semtronik/link-hardware/board/link-base-brd/outputs/link-base-brd-v0.2.0-bom.csv

Reference | Quantity | Description | Manufacturer | Manufacturer PN | DNP | Notes
C1,C2,C4,C9,C12,C21,C23 | 7 | Capacitor, 10uF, 25V, X5R, 0805 | Samsung | CL21A106KAYNNNE
C3 | 1 | Capacitor, 10uF, 10V, X5R, 0603 | TDK | C1608X5R1A106K080AC
C5 | 1 | Capacitor, 0.01uF, 50V, X7R, 0603 | Yageo | CC0603KRX7R9BB103
C6,C8,C13,C22,C24,C25 | 6 | Capacitor, 0.1uF, 50V, X7R, 0603 | Yageo | CC0603KRX7R9BB104
C7 | 1 | Capacitor, 120pF, 50V, C0G, 0603 | Samsung | CL10C121JB81PNC
C10,C11 | 2 | Capacitor, 22uF, 10V, X5R, 0805 | Samsung | CL21A226MPQNNNE
C14,C17 | 2 | Capacitor, 1uF, 50V, X5R, 0603 | Samsung | CL10A105KB8NNNC
C15,C16,C18 | 3 | Capacitor, 15pF, 50V, C0G, 0603 | Samsung | CL10C150JB8NNNC | DNP
D1,D2,D3,D4 | 4 | Diode standard, 75V 250MA, SOD123 | SMC Diode Solutions | 1N4148W
D6 | 1 | Diode, TVS, SOT-143 | Nexperia | PRTR5V0U2X,215
F1,F2 | 2 | PTC, 0.75A hold, 6V, 1206 | Bourns | MF-NSMF075-2
J1 | 1 | Connector, Header, 1x3, 2.5mm, TH | JST | B3B-XH-AM
J2 | 1 | Generic connector, double row, 02x03, odd/even pin numbering scheme (row 1 odd numbers, row 2 even numbers), script generated (kicad-library-utils/schlib/autogen/connector/) |  |  | DNP
J3 | 1 | Connector, Socket, 2x10, 2mm, Vertical, Height=4.6mm, SMD | Wurth | 621320242921 |  | HCTL - PM200-2-10-S-4.3
J5 | 1 | Connector, USB-C Receptacle 16P, USB 2.0, SMD | GCT | USB4105-GF-A
J6 | 1 | Connector, FPC, 6pos, 1mm, SMD | Molex | 52271-0679
J7 | 1 | Connector, FPC, 40pos, 0.5mm, SMD | Molex | 54132-4062
L1 | 1 | Inductor, 470nH, 4.5A, 26mOhm, 0806 | Murata | DFE201612E-R47M=P2
Q1,Q3 | 2 | Transistor, Mosfet, P-Channel, 4A, 30V, SOT-23 | Alpha & Omega Semiconductor Inc. | AO3401A
Q2 | 1 | Transistor, Mosfet, N-Channel, 5.7A, 30V, SOT-23 | Alpha & Omega Semiconductor Inc. | AO3400A
R1,R15,R16,R17,R18,R19,R20,R23,R24,R25 | 10 | Resistor,10k, 1%, 0.1W, 0603 | Yageo | RC0603FR-0710KL
R2 | 1 | Resistor,3.k, 1%, 0.1W, 0603 | Yageo | RC0603FR-073KL
R3,R4,R5,R6,R7,R11,R14,R32,R33,R34 | 10 | Resistor,100k, 1%, 0.1W, 0603 | Yageo | RC0603FR-07100KL
R8 | 1 | Resistor,1.5k, 1%, 0.1W, 0603 | Yageo | RC0603FR-071K5L
R9 | 1 | Resistor,1.8k, 1%, 0.1W, 0603 | Yageo | RC0603FR-071K8L
R10 | 1 | Resistor, 1M, 1%, 0.1W, 0603 | Yageo | RC0603FR-071ML
R12 | 1 | Resistor,453k, 1%, 0.1W, 0603 | Yageo | RC0603FR-07453KL
R13 | 1 | Resistor,150k, 1%, 0.1W, 0603 | Yageo | RC0603FR-07150KL
R21,R22 | 2 | Resistor, 22R, 1%, 0.1W, 0603 | Yageo | RC0603FR-0722RL
R30,R31 | 2 | Resistor,5.1k, 1%, 0.1W, 0603 | Yageo | RC0603FR-075K1L
R35 | 1 | Resistor,3.3k, 1%, 0.1W, 0603 | Yageo | RC0603FR-073K3L
SW1 | 1 | Tactile switch, SPST-NO, 0.05A 12V, SMD | Panasonic | EVQ-PUA02K
U1 | 1 | IC, Li-Ion Battery Charger and Power-Path Management, VQFN-16 | Texas Instruments | BQ24074RGTR
U2 | 1 | IC, BATT MON, LI-ION 1CELL, 8TDFN | Analog Devices | MAX17048G+
U3 | 1 | IC, Regulator, Buck, ADJ, 1A, QFN-8 | Texas Instruments | TPS62821DLCR
U4 | 1 | IC, MCU, ESP32-S3-WROOM, 16MB Flash, 8MB PSRAM, Int. Ant. | Espressif | ESP32-S3-WROOM-1-N16R8
U5 | 1 | Realtime Clock/Calendar I2C Interface, SOIC-8 | NXP | PCF8563T/5,518
U6 | 1 | IC, Led Driver Linear, 175mA, 8SOIC | onsemi | CAT4104V-GT3
Y1 | 1 | Crystal, 32.768Khz, 9pF, SMD | Micro Crystal AG | CM8V-T1A-32.768KHZ-9PF-20PPM-TA-QC
