semtronik/link-hardware/board/link-base-brd/outputs/link-base-brd-v0.2.0.step

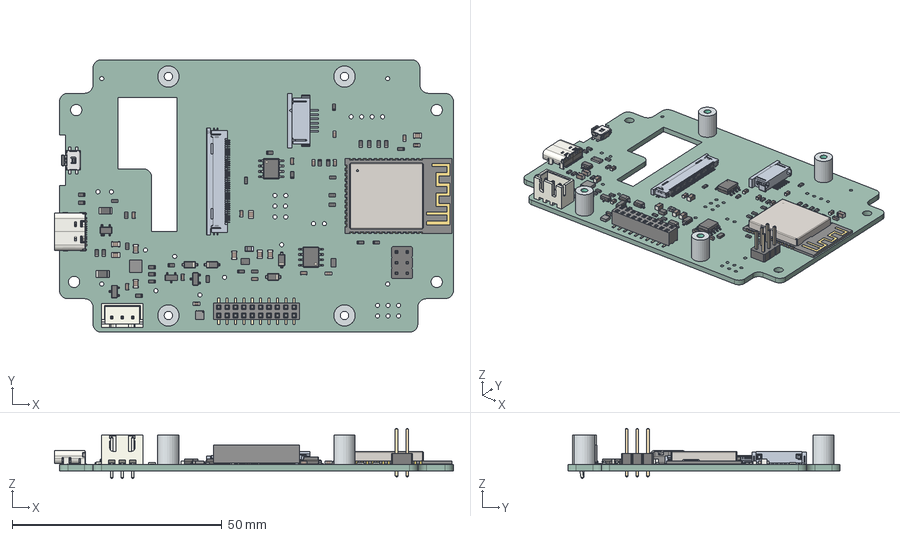
[picture p1: CAD file, 2026-08-31]
board/link-base-brd/outputs/link-base-brd-v0.2.0.step
95.2 x 65.0 x 11.9 mm
PinHeader_2x03_P254mm_Vertical
BODY-QFN
PIN1-ID
SOIC_8_39x49mm_P127mm x 2
R_0603_1608Metric x 31
USB_C_Receptacle_16P_TopMnt_Horizontal_GCT_USB4105-xx-A
C_0805_2012Metric x 9
C_0603_1608Metric x 14
SOT_143
MicroCrystal_CC8V_T1A
D_SOD_123 x 4
Body^BF100-xxxx_20
Pin^BF100-xxxx x 10
Fuse_1206_3216Metric x 2
C0201_20210301.STEP^C0201_20210301.STEP_Submodel-C0201_part_ DesignRootModel_PCB_ESP32-S3-WROOM-1_V1(2)_PCB_ESP32-S3-WROOM-1_V1 x 14
L0201_20210301.STEP^L0201_20210301.STEP_Submodel-L0201_part_ DesignRootModel_PCB_ESP32-S3-WROOM-1_V1(2)_PCB_ESP32-S3-WROOM-1_V1 x 3
C0402_20210301.STEP^C0402_20210301.STEP_Submodel-C0402_part_ DesignRootModel_PCB_ESP32-S3-WROOM-1_V1(2)_PCB_ESP32-S3-WROOM-1_V1
R0201_20210301.STEP^R0201_20210301.STEP_Submodel-R0201_part_ DesignRootModel_PCB_ESP32-S3-WROOM-1_V1(2)_PCB_ESP32-S3-WROOM-1_V1 x 8
trace_1^Submodel-MINI-ANT-TYPEB_668419613_part_DesignRootModel_PCB_ ESP32-S3-WROOM-1_V1(2)_PCB_ESP32-S3-WROOM-1_V1
DFN1006.STEP^DFN1006.STEP_Submodel-SOD882_part_DesignRootModel_PCB_ ESP32-S3-WROOM-1_V1(2)_PCB_ESP32-S3-WROOM-1_V1
SOP8_rev1_20210308.STEP^SOP8_rev1_20210308.STEP_Submodel-SOP8_1P27_6P6_ part_DesignRootModel_PCB_ESP32-S3-WROOM-1_V1(2)_PCB_ESP32-S3-WROOM-1_V1
XTAL3225_20210301.STEP^XTAL3225_20210301.STEP_Submodel-XTAL3225_part_ DesignRootModel_PCB_ESP32-S3-WROOM-1_V1(2)_PCB_ESP32-S3-WROOM-1_V1
ESP32-S3_20210301.STEP^ESP32-S3_20210301.STEP_Submodel-QFN56_0P4_7_ part_DesignRootModel_PCB_ESP32-S3-WROOM-1_V1(2)_PCB_ESP32-S3-WROOM-1_V1
uid__4-128^DesignRootModel_PCB_ESP32-S3-WROOM-1_V1(2)_PCB_ ESP32-S3-WROOM-1_V1
uid__4-129^DesignRootModel_PCB_ESP32-S3-WROOM-1_V1(2)_PCB_ ESP32-S3-WROOM-1_V1
uid__4-130^DesignRootModel_PCB_ESP32-S3-WROOM-1_V1(2)_PCB_ ESP32-S3-WROOM-1_V1
uid__4-149^DesignRootModel_PCB_ESP32-S3-WROOM-1_V1(2)_PCB_ ESP32-S3-WROOM-1_V1
uid__4-150^DesignRootModel_PCB_ESP32-S3-WROOM-1_V1(2)_PCB_ ESP32-S3-WROOM-1_V1
uid__4-151^DesignRootModel_PCB_ESP32-S3-WROOM-1_V1(2)_PCB_ ESP32-S3-WROOM-1_V1
uid__4-167^DesignRootModel_PCB_ESP32-S3-WROOM-1_V1(2)_PCB_ ESP32-S3-WROOM-1_V1
uid__4-168^DesignRootModel_PCB_ESP32-S3-WROOM-1_V1(2)_PCB_ ESP32-S3-WROOM-1_V1
uid__4-169^DesignRootModel_PCB_ESP32-S3-WROOM-1_V1(2)_PCB_ ESP32-S3-WROOM-1_V1
uid__1-279^DesignRootModel_PCB_ESP32-S3-WROOM-1_V1(2)_PCB_ ESP32-S3-WROOM-1_V1
uid__1-280^DesignRootModel_PCB_ESP32-S3-WROOM-1_V1(2)_PCB_ ESP32-S3-WROOM-1_V1
uid__1-292^DesignRootModel_PCB_ESP32-S3-WROOM-1_V1(2)_PCB_ ESP32-S3-WROOM-1_V1
uid__1-298^DesignRootModel_PCB_ESP32-S3-WROOM-1_V1(2)_PCB_ ESP32-S3-WROOM-1_V1
uid__1-299^DesignRootModel_PCB_ESP32-S3-WROOM-1_V1(2)_PCB_ ESP32-S3-WROOM-1_V1
uid__1-300^DesignRootModel_PCB_ESP32-S3-WROOM-1_V1(2)_PCB_ ESP32-S3-WROOM-1_V1
uid__1-301^DesignRootModel_PCB_ESP32-S3-WROOM-1_V1(2)_PCB_ ESP32-S3-WROOM-1_V1
uid__1-304^DesignRootModel_PCB_ESP32-S3-WROOM-1_V1(2)_PCB_ ESP32-S3-WROOM-1_V1
uid__1-305^DesignRootModel_PCB_ESP32-S3-WROOM-1_V1(2)_PCB_ ESP32-S3-WROOM-1_V1
uid__1-308^DesignRootModel_PCB_ESP32-S3-WROOM-1_V1(2)_PCB_ ESP32-S3-WROOM-1_V1
uid__1-310^DesignRootModel_PCB_ESP32-S3-WROOM-1_V1(2)_PCB_ ESP32-S3-WROOM-1_V1
uid__1-311^DesignRootModel_PCB_ESP32-S3-WROOM-1_V1(2)_PCB_ ESP32-S3-WROOM-1_V1
uid__1-325^DesignRootModel_PCB_ESP32-S3-WROOM-1_V1(2)_PCB_ ESP32-S3-WROOM-1_V1
uid__1-334^DesignRootModel_PCB_ESP32-S3-WROOM-1_V1(2)_PCB_ ESP32-S3-WROOM-1_V1
uid__1-338^DesignRootModel_PCB_ESP32-S3-WROOM-1_V1(2)_PCB_ ESP32-S3-WROOM-1_V1
uid__1-339^DesignRootModel_PCB_ESP32-S3-WROOM-1_V1(2)_PCB_ ESP32-S3-WROOM-1_V1
uid__1-340^DesignRootModel_PCB_ESP32-S3-WROOM-1_V1(2)_PCB_ ESP32-S3-WROOM-1_V1
uid__1-343^DesignRootModel_PCB_ESP32-S3-WROOM-1_V1(2)_PCB_ ESP32-S3-WROOM-1_V1
uid__1-344^DesignRootModel_PCB_ESP32-S3-WROOM-1_V1(2)_PCB_ ESP32-S3-WROOM-1_V1
uid__1-345^DesignRootModel_PCB_ESP32-S3-WROOM-1_V1(2)_PCB_ ESP32-S3-WROOM-1_V1
uid__1-352^DesignRootModel_PCB_ESP32-S3-WROOM-1_V1(2)_PCB_ ESP32-S3-WROOM-1_V1
uid__1-354^DesignRootModel_PCB_ESP32-S3-WROOM-1_V1(2)_PCB_ ESP32-S3-WROOM-1_V1
uid__1-355^DesignRootModel_PCB_ESP32-S3-WROOM-1_V1(2)_PCB_ ESP32-S3-WROOM-1_V1
uid__1-357^DesignRootModel_PCB_ESP32-S3-WROOM-1_V1(2)_PCB_ ESP32-S3-WROOM-1_V1
uid__1-358^DesignRootModel_PCB_ESP32-S3-WROOM-1_V1(2)_PCB_ ESP32-S3-WROOM-1_V1
uid__1-359^DesignRootModel_PCB_ESP32-S3-WROOM-1_V1(2)_PCB_ ESP32-S3-WROOM-1_V1
uid__1-364^DesignRootModel_PCB_ESP32-S3-WROOM-1_V1(2)_PCB_ ESP32-S3-WROOM-1_V1
uid__1-365^DesignRootModel_PCB_ESP32-S3-WROOM-1_V1(2)_PCB_ ESP32-S3-WROOM-1_V1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
