semtronik/link-hardware/board/link-mod-lr-brd/outputs/link-mod-lr-brd-v0.2.0.step

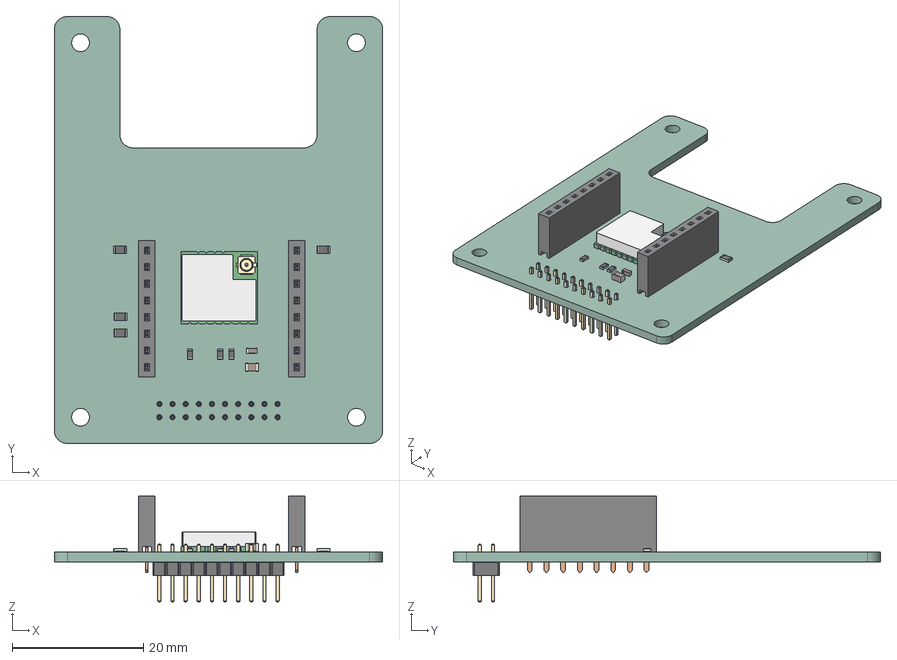
[picture p2: CAD file, 2026-08-31]
board/link-mod-lr-brd/outputs/link-mod-lr-brd-v0.2.0.step
50.0 x 65.0 x 16.1 mm
C_0603_1608Metric
6130xx11821_PIN x 16
R_0805_2012Metric x 4
PCB
PCB001
PCB002
R_0603_1608Metric x 3
C_0805_2012Metric
PinHeader_2x10_P200mm_Vertical
link-mod-lr-brd_PCB
