semtronik/link-hardware/mechanical/link-case-bot-v0.1.0.step

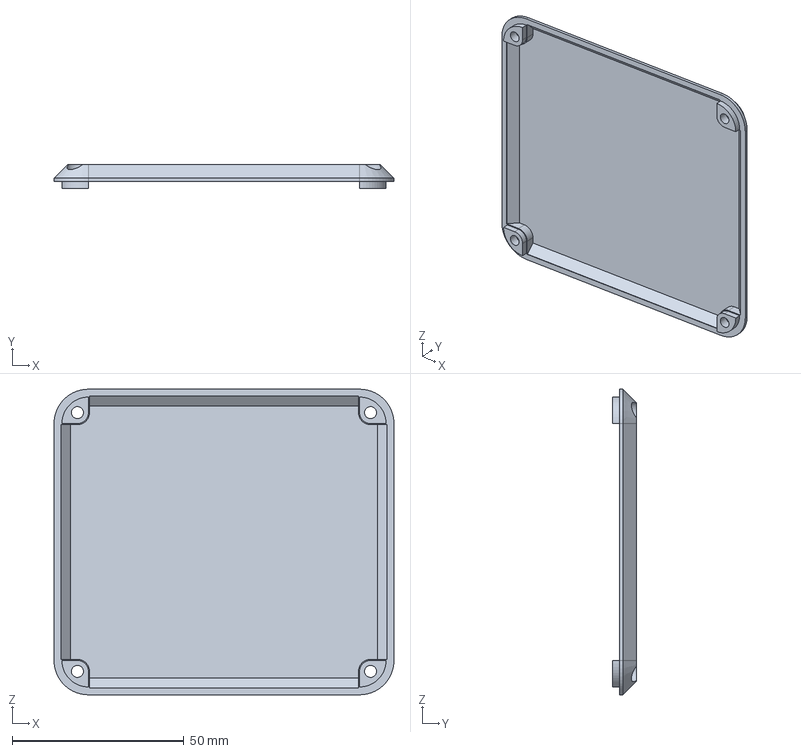
[picture p3: CAD file, 2026-08-31]
mechanical/link-case-bot-v0.1.0.step
99.0 x 7.00 x 89.0 mm
