semtronik/link-hardware/mechanical/link-case-top-v0.1.0.step

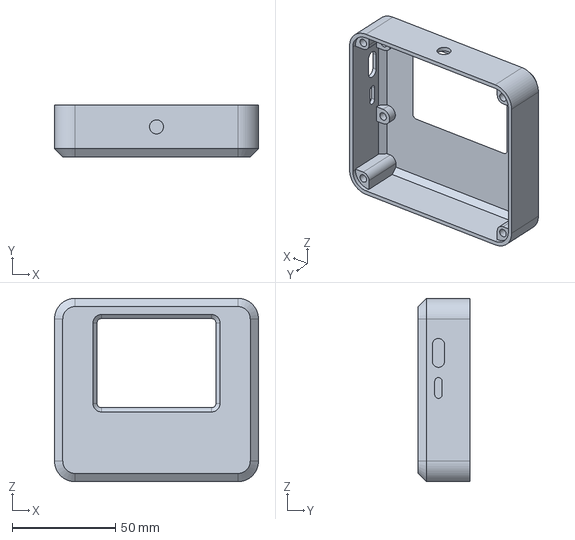
[picture p4: CAD file, 2026-08-31]
mechanical/link-case-top-v0.1.0.step
99.0 x 25.0 x 89.0 mm
