semtronik/link-hardware/board/link-base-brd/outputs/link-base-brd-v0.2.0-schematic.pdf

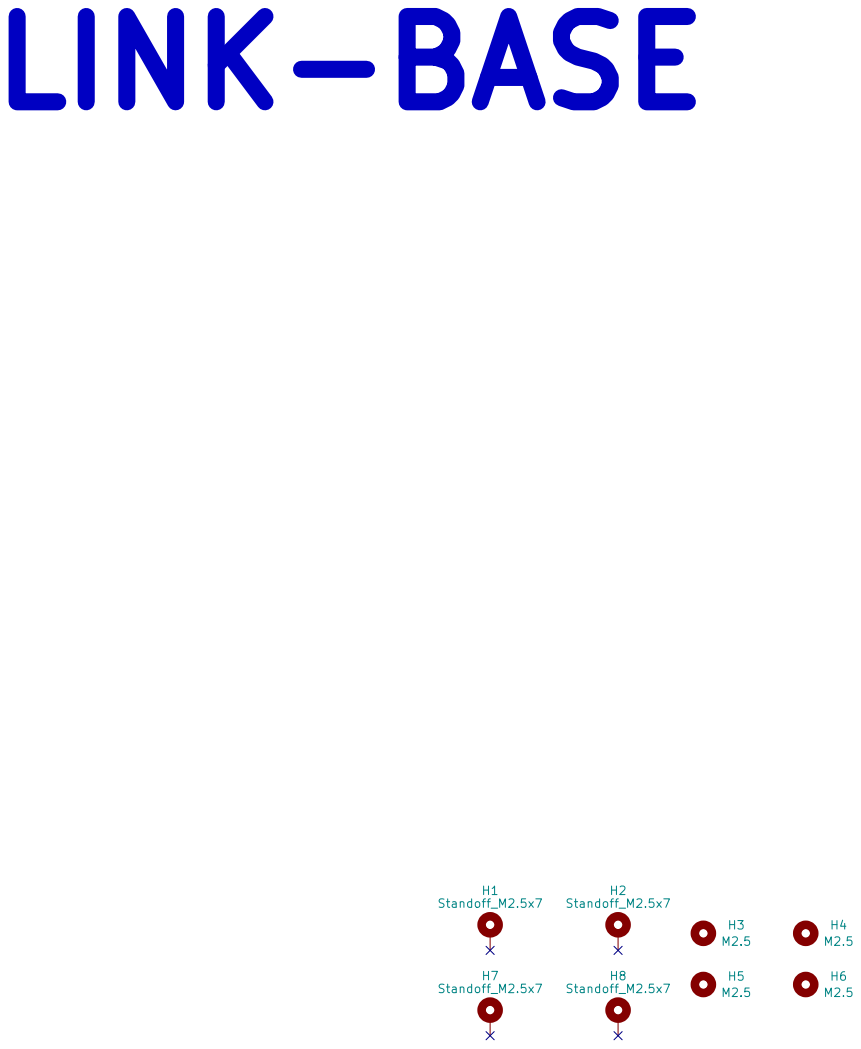
[picture p5: page 1]

Sheet: /link-base-brd/
File: link-base-brd.kicad_sch
Title: Link Base Board

Size: A3 | Rev: 0.2.0 | F Date: 2026-08-28
KiCad E.D.A. 10.0.5 | Id: 1/6

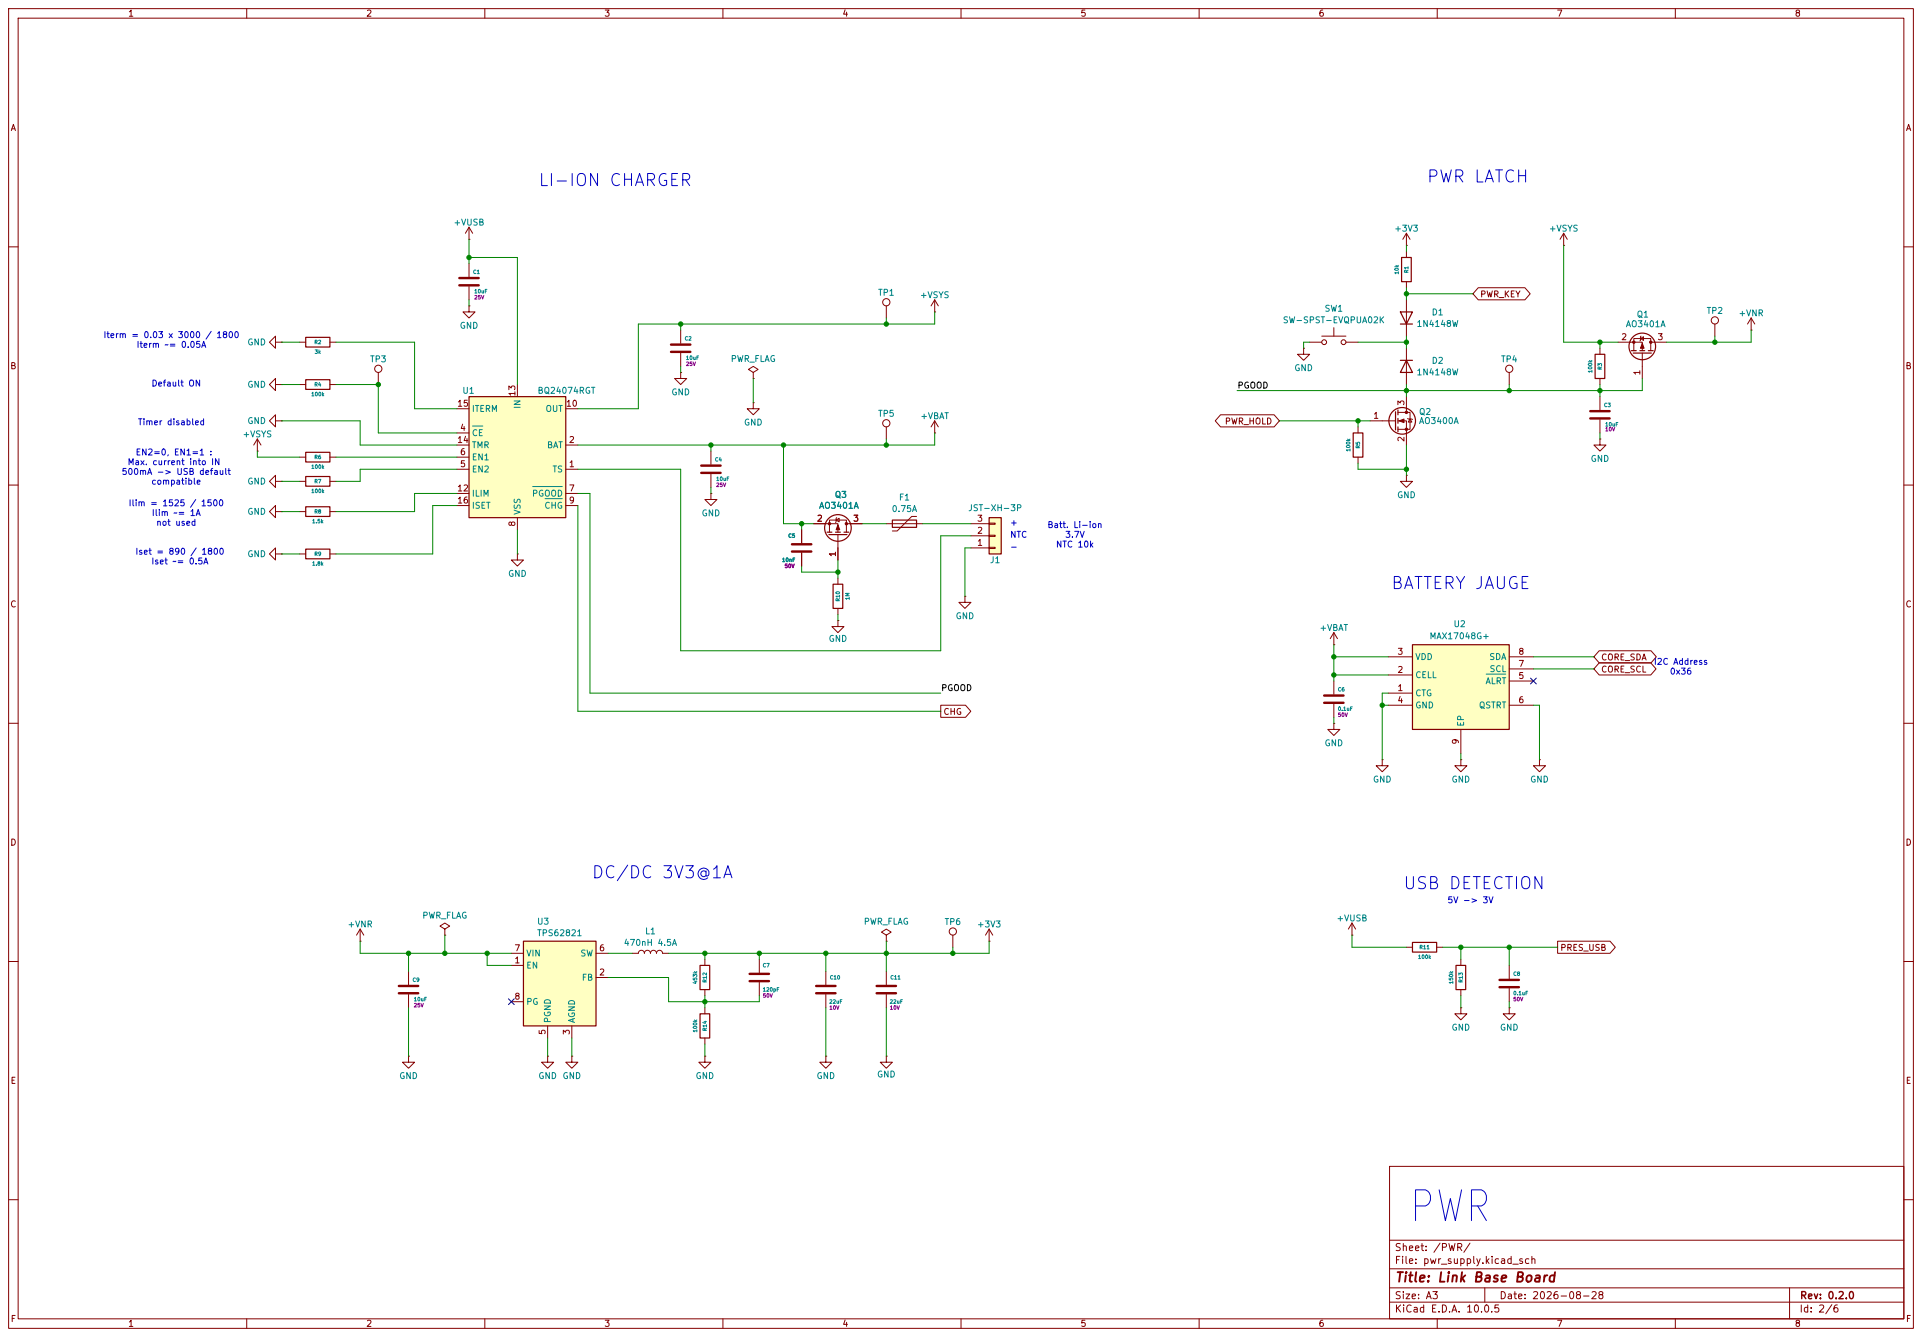
[picture p6: page 2]

Iterm = 0.03 x 3000 / 1800
Iterm ~= 0.05A EN2=0, EN1=1 : Max. current into IN 500mA -> USB default compatible

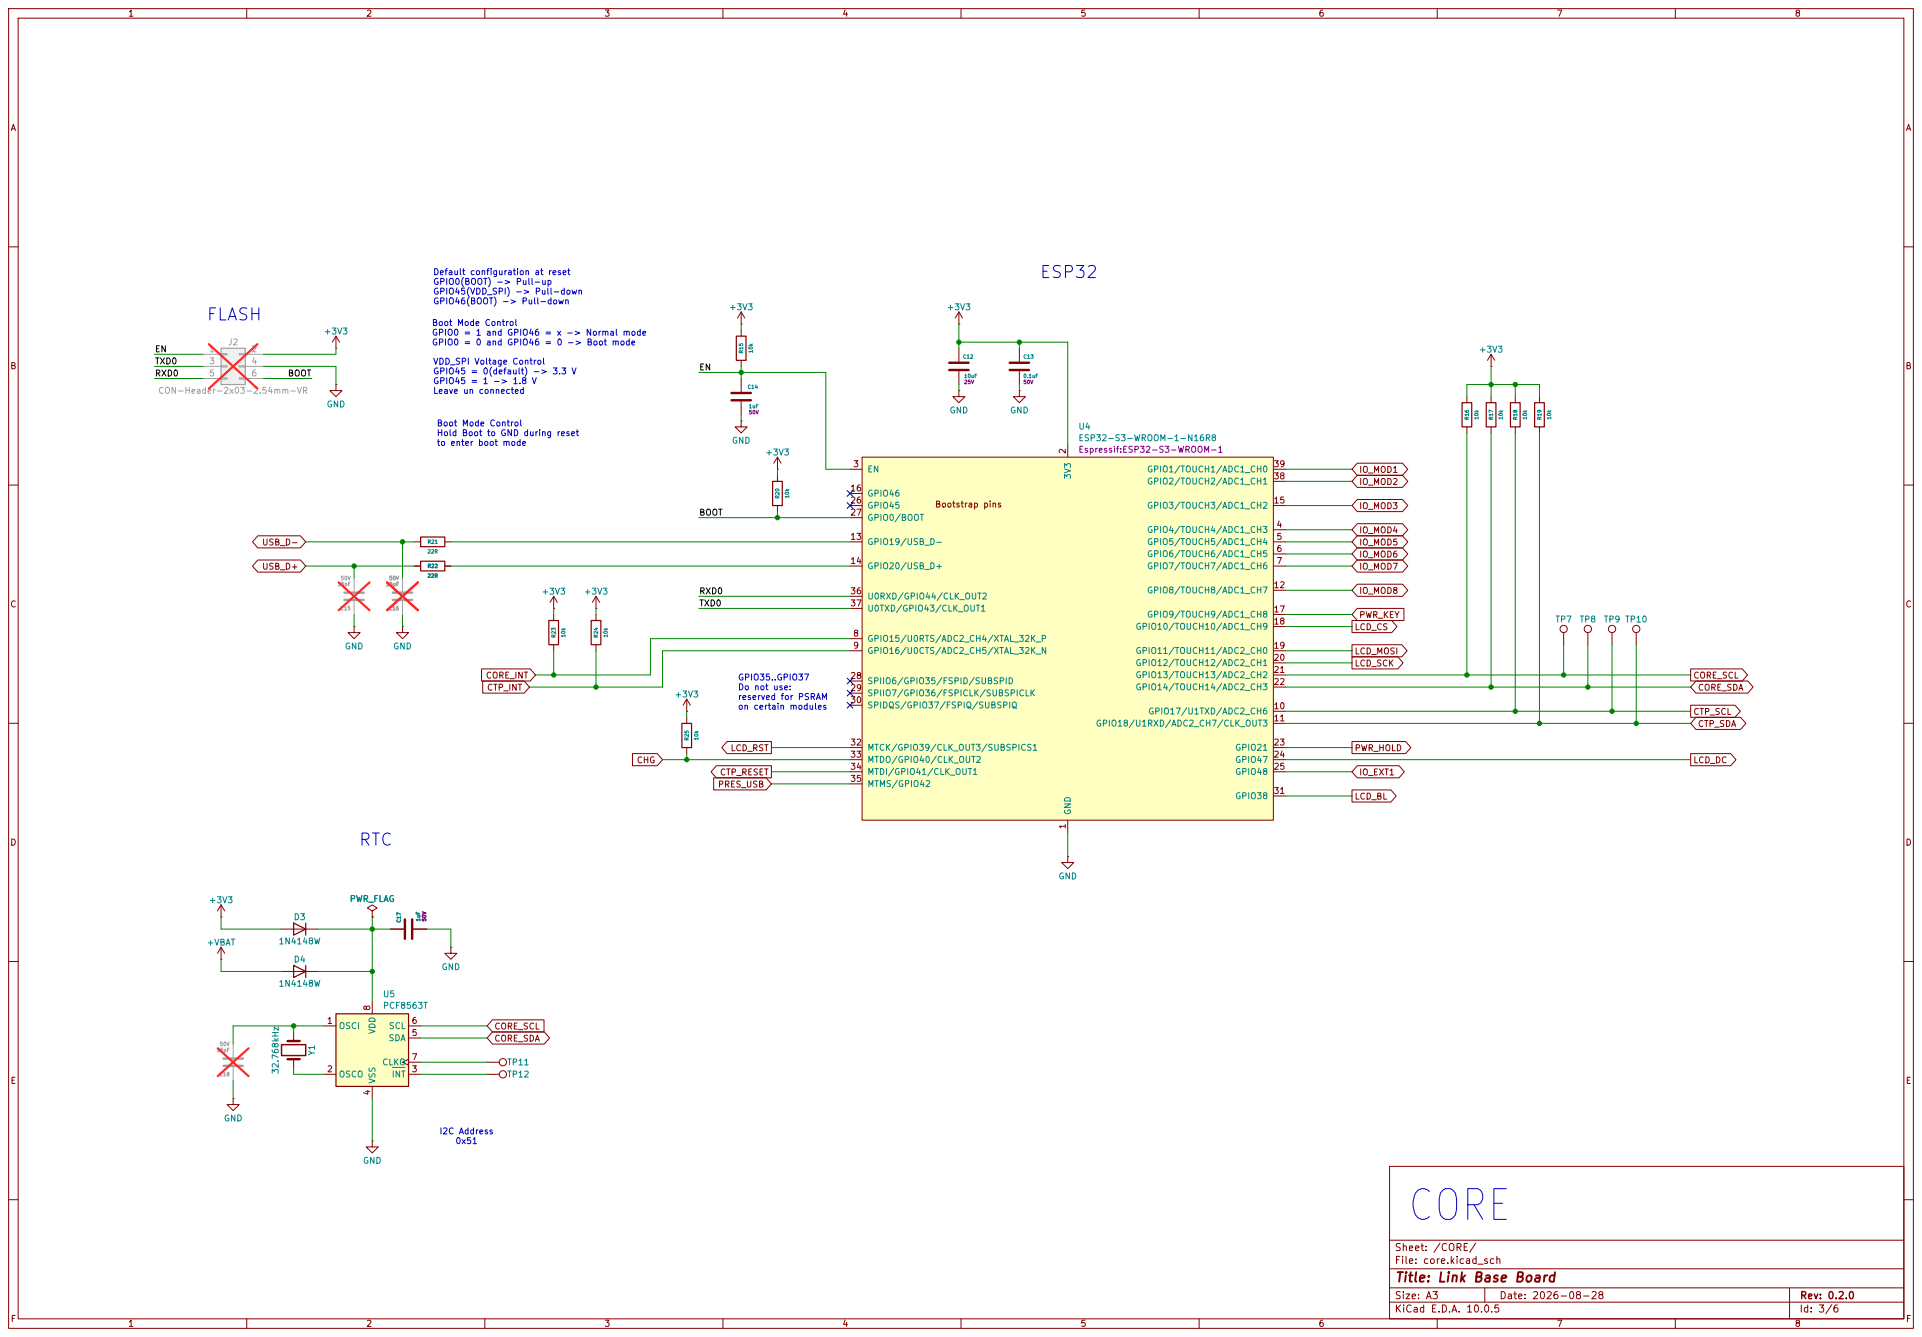
[picture p7: page 3]

Default configuration at reset GPIO0(BOOT) -> Pull-up

Boot Mode Control GPIO0 = 1 and GPIO46 = x -> Normal mode GPIO0 = 0 and GPIO46 = 0 -> Boot mode RTC

Boot Mode Control Hold Boot to GND during reset

reserved for PSRAM on certain modules

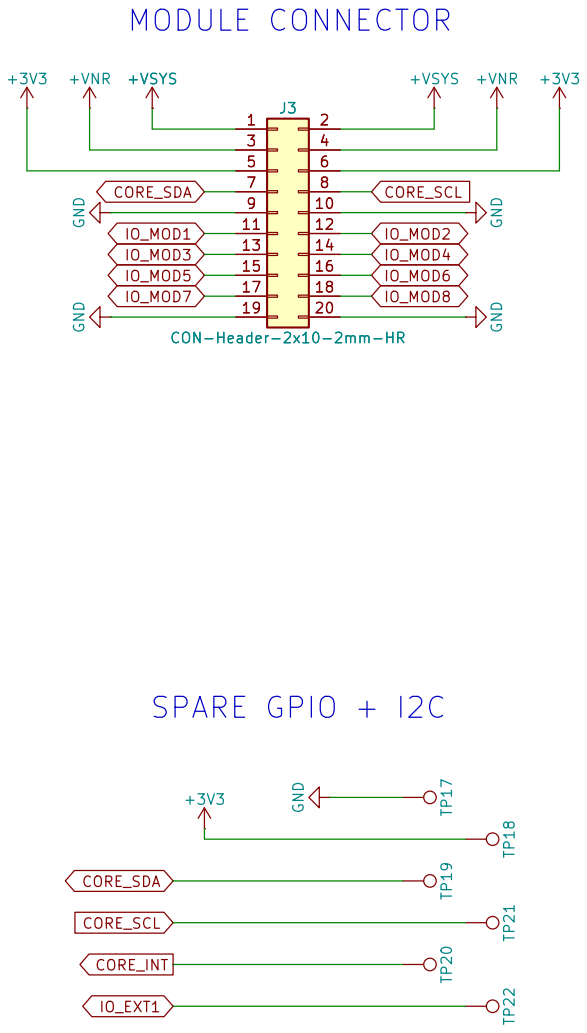
[picture p8: page 4]

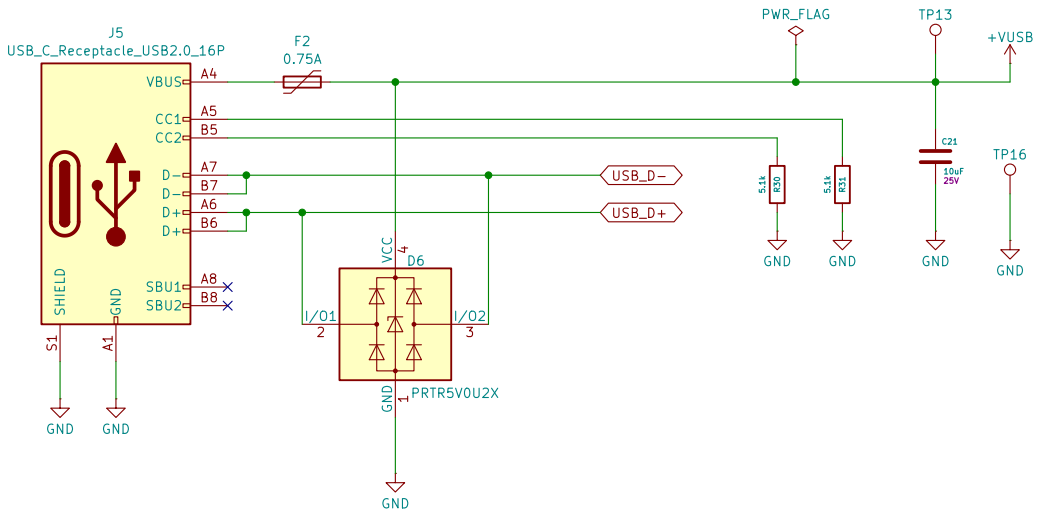
[picture p9: page 5]

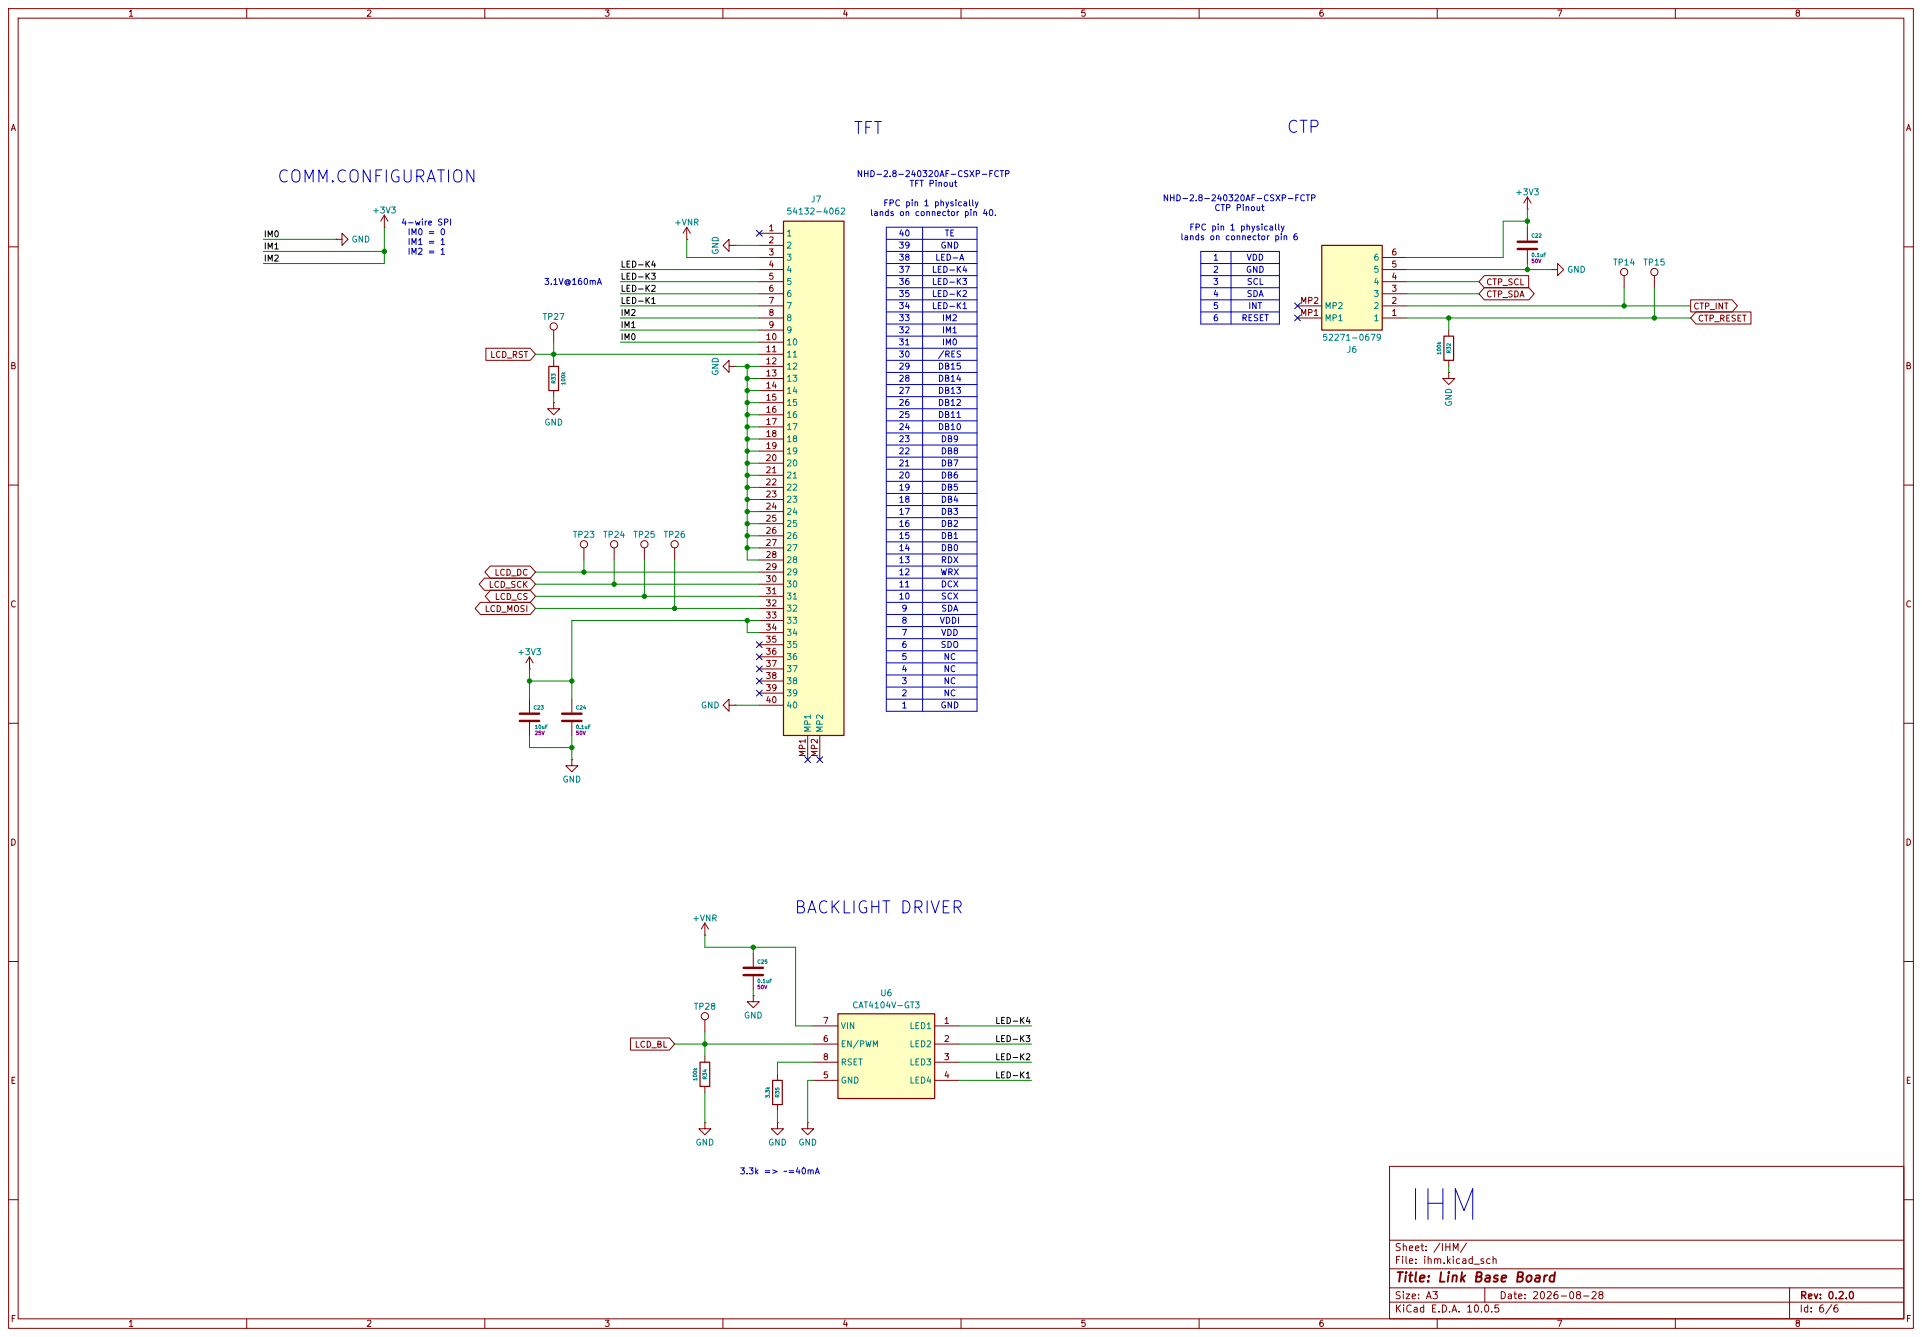
[picture p10: page 6]

TFT Pinout FPC pin 1 physically

NHD-2.8-240320AF-CSXP-FCTP
CTP Pinout FPC pin 1 physically

lands on connector pin 6

2 | GND

36 | LED-K3
35 | LED-K2
34 | LED-K1
33 | IM2
32 | IM1
31 | IM0
30 | /RES
29 | DB15
28 | DB14
27 | DB13
26 | DB12
25 | DB11
24 | DB10
23 | DB9
22 | DB8
21 | DB7
20 | DB6
19 | DB5
18 | DB4
17 | DB3
16 | DB2
15 | DB1
14 | DB0
13 | RDX
12 | WRX
11 | DCX
10 | SCX
9 | VDDI 7 VDD SDA 8

6 | SDO
5 | NC
4 | NC
3 | NC
2 | NC
1 | GND
