semtronik/link-hardware/board/link-mod-lr-brd/outputs/link-mod-lr-brd-v0.2.0-schematic.pdf

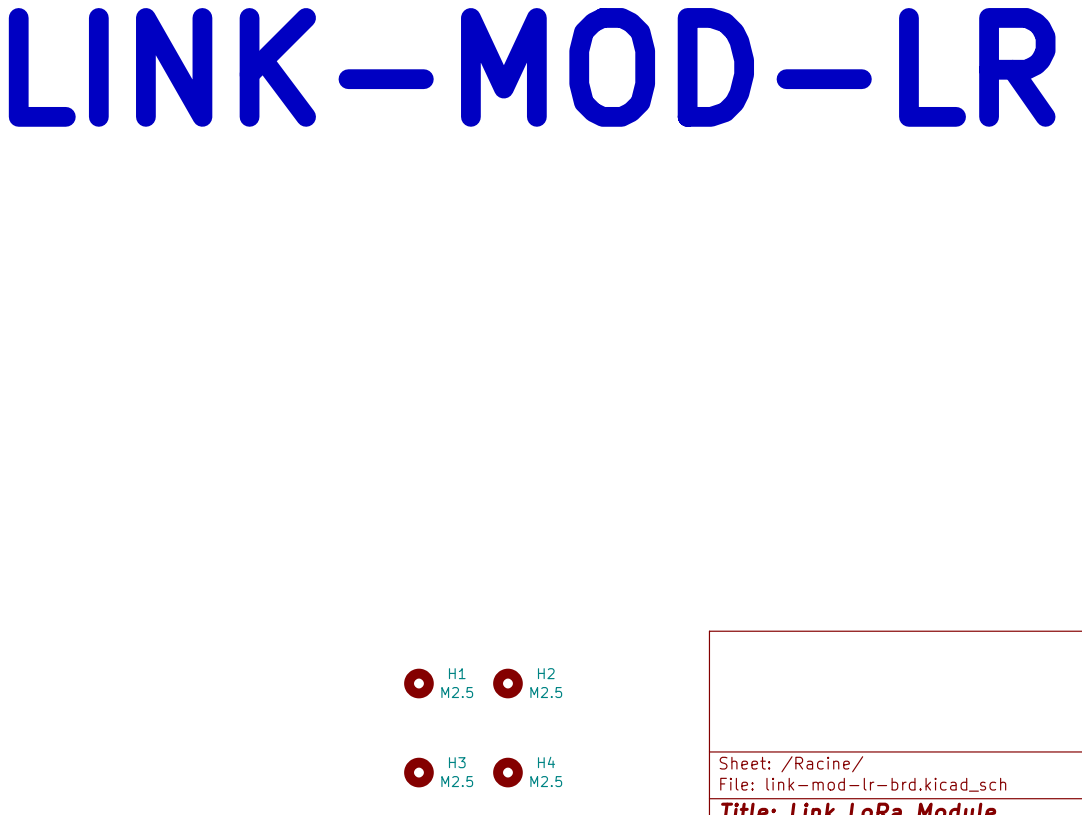
[picture p11: page 1]

Sheet: /Racine/
File: link-mod-lr-brd.kicad_sch
Title: Link LoRa Module

Size: A4 | Rev: 0.2.0
KiCad E.D.A. 10.0.5 | Id: 1/2

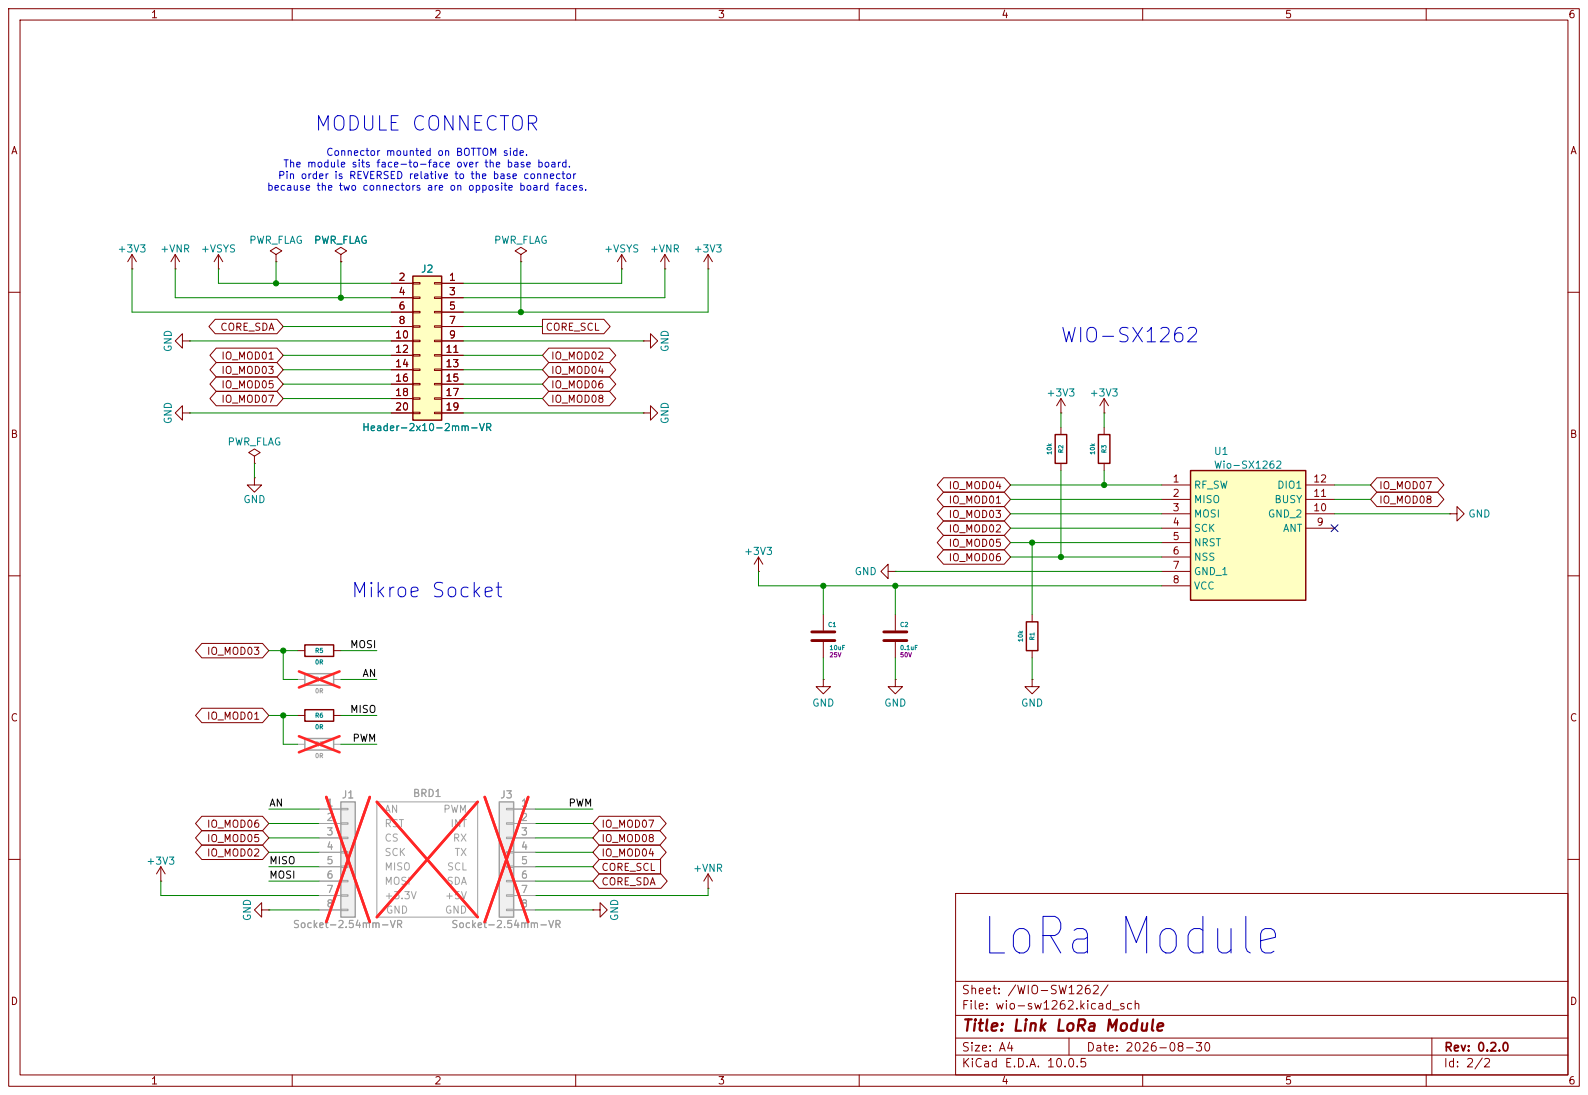
[picture p12: page 2]

BRD1
RST CS
SCK MISO MOSI +3.3V GND
SCL SDA +5V GND

File: wio-sw1262.kicad_sch
Title: Link LoRa Module

Size: A4 | Rev: 0.2.0
KiCad E.D.A. 10.0.5 | Id: 2/2
