semtronik/link-hardware/board/link-mod-lr-brd/link-mod-lr-brd.kicad_pcb

## KiCad design board/link-mod-lr-brd/link-mod-lr-brd.kicad_pcb (2026-08-31)

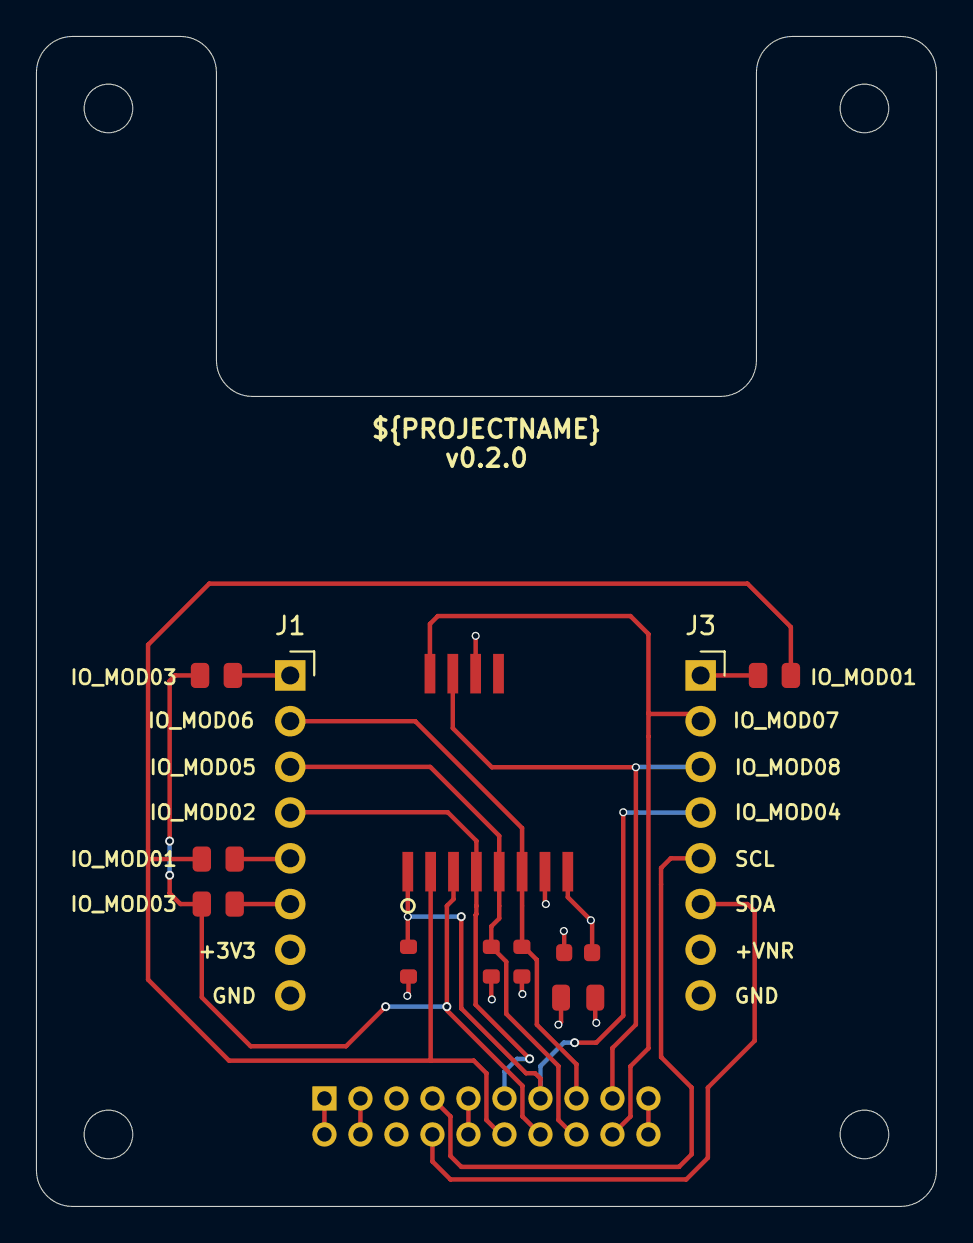
[picture p13: board link-mod-lr-brd.kicad_pcb from above]

Board: 4 copper layers, 50.0 x 65.0 mm, 18 parts (1 on the bottom side), 18 nets.

Parts:
BRD1: BRD-MIKROE-S
C1: 10uF; C_0805_2012Metric
C2: 0.1uF; C_0603_1608Metric
H1, H2, H3, H4: M2.5; MountingHole_2.7mm_M2.5
J1, J3: Socket-2.54mm-VR; PinSocket_1x08_P2.54mm_Vertical
J2: Header-2x10-2mm-VR; PinHeader_2x10_P2.00mm_Vertical
R1, R2, R3: 10k; R_0603_1608Metric
R4, R5, R6, R7: 0R; R_0805_2012Metric
U1: Wio-SX1262; WioSX1262

Connections:
+3V3: C1.1, C2.1, J1.7, J2.5, J2.6, R2.1, R3.1, U1.8 (VCC)
+VNR: J2.3, J2.4, J3.7
+VSYS: J2.1, J2.2
/WIO-SW1262/AN: J1.1, R4.2
/WIO-SW1262/MISO: J1.5, R6.2
/WIO-SW1262/MOSI: J1.6, R5.2
/WIO-SW1262/PWM: J3.1, R7.2
CORE_SCL: J2.7, J3.5
CORE_SDA: J2.8, J3.6
GND: C1.2, C2.2, J1.8, J2.9, J2.10, J2.19, J2.20, J3.8, R1.2, U1.7 (GND_1), U1.10 (GND_2)
IO_MOD01: J2.12, R6.1, R7.1, U1.2 (MISO)
IO_MOD02: J1.4, J2.11, U1.4 (SCK)
IO_MOD03: J2.14, R4.1, R5.1, U1.3 (MOSI)
IO_MOD04: J2.13, J3.4, R3.2, U1.1 (RF_SW)
IO_MOD05: J1.3, J2.16, R1.1, U1.5 (NRST)
IO_MOD06: J1.2, J2.15, R2.2, U1.6 (NSS)
IO_MOD07: J2.18, J3.2, U1.12 (DIO1)
IO_MOD08: J2.17, J3.3, U1.11 (BUSY)
