semtronik/link-hardware/board/link-base-brd/link-base-brd.kicad_pcb

## KiCad design board/link-base-brd/link-base-brd.kicad_pcb (2026-08-31)

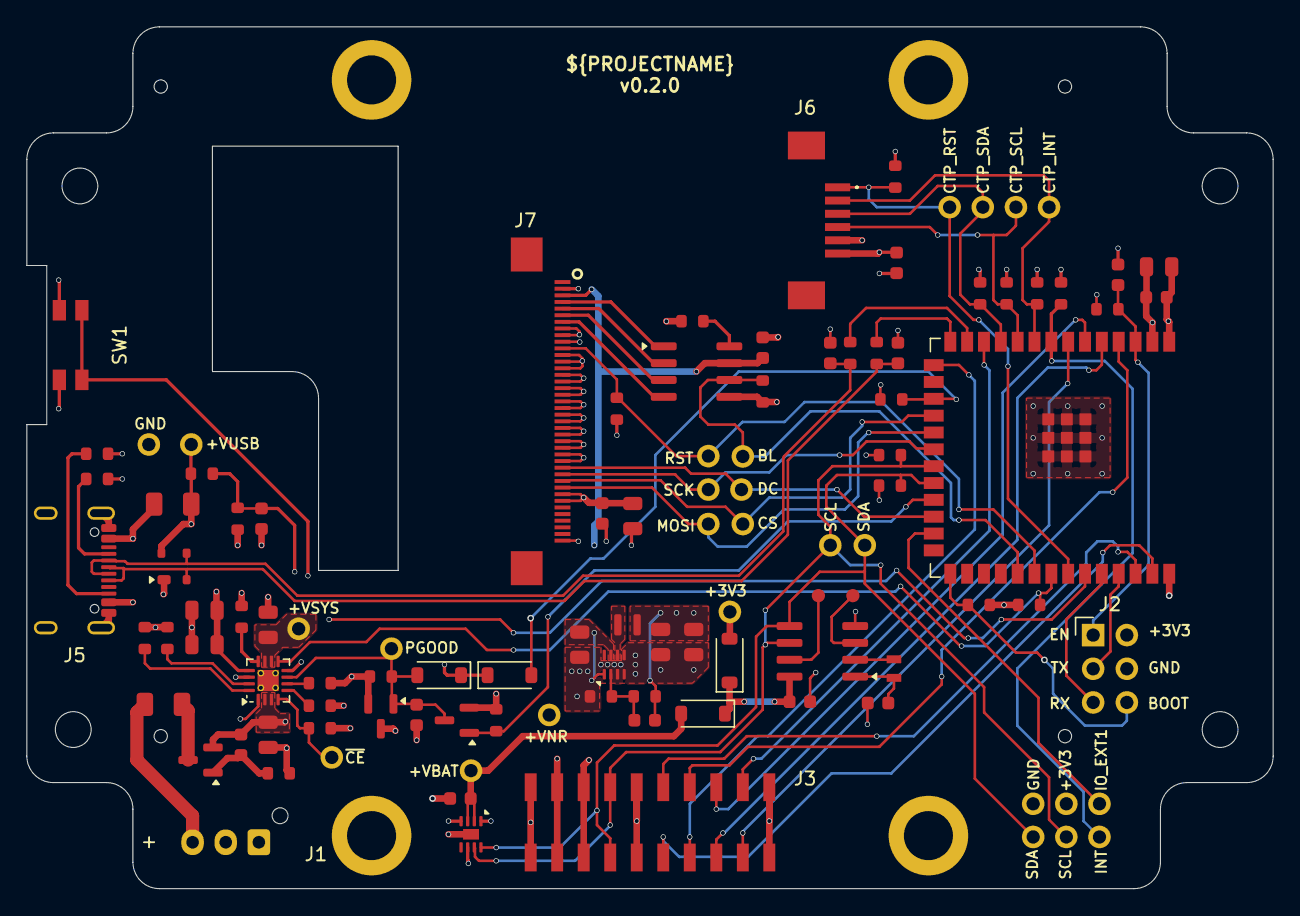
[picture p14: board link-base-brd.kicad_pcb from above]

Board: 4 copper layers, 94.0 x 65.0 mm, 115 parts (0 on the bottom side), 67 nets.

Parts:
C1, C2, C4, C9, C12, C21, C23: 10uF; C_0805_2012Metric
C3: 10uF; C_0603_1608Metric
C5: 10nF; C_0603_1608Metric
C6, C8, C13, C22, C24, C25: 0.1uF; C_0603_1608Metric
C7: 120pF; C_0603_1608Metric
C10, C11: 22uF; C_0805_2012Metric
C14, C17: 1uF; C_0603_1608Metric
C15, C16, C18: 15pF; C_0603_1608Metric
D1, D2, D3, D4: 1N4148W; D_SOD-123
D6: PRTR5V0U2X; SOT-143
F1, F2: 0.75A; Fuse_1206_3216Metric
H1, H2, H7, H8: Standoff_M2.5x7; WA-SMSI_9774070151
H3, H4, H5, H6: M2.5; MountingHole_2.7mm_M2.5
J1: JST-XH-3P; JST_XH_B3B-XH-AM_1x03_P2.50mm_Vertical
J2: CON-Header-2x03-2.54mm-VR; PinHeader_2x03_P2.54mm_Vertical
J3: CON-Header-2x10-2mm-HR; PinSocket_2x10_P2.00mm_Vertical_SMD
J5: USB_C_Receptacle_USB2.0_16P; USB_C_Receptacle_GCT_USB4105-xx-A_16P_TopMnt_Horizontal
J6: 52271-0679; 522710679
J7: 54132-4062; 54132-4062_1
L1: 470nH 4.5A; L_Murata_DFE201610P
Q1, Q3: AO3401A; SOT-23
Q2: AO3400A; SOT-23
R1, R15, R16, R17, R18, R19, R20, R23, R24, R25: 10k; R_0603_1608Metric
R2: 3k; R_0603_1608Metric
R3, R4, R5, R6, R7, R11, R14, R32, R33, R34: 100k; R_0603_1608Metric
R8: 1.5k; R_0603_1608Metric
R9: 1.8k; R_0603_1608Metric
R10: 1M; R_0603_1608Metric
R12: 453k; R_0603_1608Metric
R13: 150k; R_0603_1608Metric
R21, R22: 22R; R_0603_1608Metric
R30, R31: 5.1k; R_0603_1608Metric
R35: 3.3k; R_0603_1608Metric
SW1: SW-SPST-EVQPUA02K; Panasonic_EVQPUJ_EVQPUA
TP1, TP2, TP3, TP4, TP5, TP6, TP7, TP8, TP9, TP10, TP13, TP14, TP15, TP16, TP17, TP18, TP19, TP20, TP21, TP22, TP23, TP24, TP25, TP26, TP27, TP28: TP-PAD-D1.0mm; TestPoint_THTPad_D1.0mm_Drill0.5mm
TP11, TP12: TP-PAD-D1.0mm; TestPoint_Pad_D1.0mm
U1: BQ24074RGT; VQFN-16-1EP_3x3mm_P0.5mm_EP1.6x1.6mm_ThermalVias
U2: MAX17048G+; TDFN-8-1EP_2x2mm_P0.5mm_EP0.8x1.2mm
U3: TPS62821; Texas_VSON-HR-8_1.5x2mm_P0.5mm
U4: ESP32-S3-WROOM-1-N16R8; ESP32-S3-WROOM-1
U5: PCF8563T; SOIC-8_3.9x4.9mm_P1.27mm
U6: CAT4104V-GT3; SOIC-8_3.9x4.9mm_P1.27mm
Y1: 32.768kHz; Crystal_SMD_2012-2Pin_2.0x1.2mm

Connections:
+3V3: C7.1, C10.1, C11.1, C12.1, C13.1, C22.1, C23.1, C24.1, D3.2 (A), J2.2, J3.5, J3.6, J6.6, J7.8, J7.9, J7.33, J7.34, L1.2, R1.1, R12.1, R15.2, R16.2, R17.2, R18.2, R19.2, R20.2, R23.2, R24.2, R25.1, TP6.1 (1_1), TP18.1 (1_1), U4.2 (3V3)
+VBAT: C4.1, C5.1, C6.1, D4.2 (A), Q3.2 (S), TP5.1 (1_1), U1.2 (BAT), U1.3 (BAT), U2.2 (CELL), U2.3 (VDD)
+VNR: C9.1, C25.1, J3.3, J3.4, J7.3, Q1.3 (D), TP2.1 (1_1), U3.1 (EN), U3.7 (VIN), U6.7 (VIN)
+VSYS: C2.1, J3.1, J3.2, Q1.2 (S), R3.1, R6.1, TP1.1 (1_1), U1.10 (OUT), U1.11 (OUT)
+VUSB: C1.1, C21.1, D6.4 (VCC), F2.2, R11.1, TP13.1 (1_1), U1.13 (IN)
/CORE/BOOT: J2.6, R20.1, U4.27 (GPIO0/BOOT)
/CORE/EN: C14.1, J2.1, R15.1, U4.3 (EN)
/CORE/RXD0: J2.5, U4.36 (U0RXD/GPIO44/CLK_OUT2)
/CORE/TXD0: J2.3, U4.37 (U0TXD/GPIO43/CLK_OUT1)
/IHM/LED-K1: J7.7, U6.4 (LED4)
/IHM/LED-K2: J7.6, U6.3 (LED3)
/IHM/LED-K3: J7.5, U6.2 (LED2)
/IHM/LED-K4: J7.4, U6.1 (LED1)
/PWR/PGOOD: C3.1, D2.2 (A), Q1.1 (G), Q2.3 (D), R3.2, TP4.1 (1_1), U1.7 (~PGOOD)
CHG: R25.2, U1.9 (~CHG), U4.33 (MTDO/GPIO40/CLK_OUT2)
CORE_INT: R23.1, TP20.1 (1_1), U4.8 (GPIO15/U0RTS/ADC2_CH4/XTAL_32K_P)
CORE_SCL: J3.8, R16.1, TP7.1 (1_1), TP21.1 (1_1), U2.7 (SCL), U4.21 (GPIO13/TOUCH13/ADC2_CH2), U5.6 (SCL)
CORE_SDA: J3.7, R17.1, TP8.1 (1_1), TP19.1 (1_1), U2.8 (SDA), U4.22 (GPIO14/TOUCH14/ADC2_CH3), U5.5 (SDA)
CTP_INT: J6.2, R24.1, TP14.1 (1_1), U4.9 (GPIO16/U0CTS/ADC2_CH5/XTAL_32K_N)
CTP_RESET: J6.1, R32.1, TP15.1 (1_1), U4.34 (MTDI/GPIO41/CLK_OUT1)
CTP_SCL: J6.4, R18.1, TP9.1 (1_1), U4.10 (GPIO17/U1TXD/ADC2_CH6)
CTP_SDA: J6.3, R19.1, TP10.1 (1_1), U4.11 (GPIO18/U1RXD/ADC2_CH7/CLK_OUT3)
GND: C1.2, C2.2, C3.2, C4.2, C6.2, C8.2, C9.2, C10.2, C11.2, C12.2, C13.2, C14.2, C15.1, C16.1, C17.2, C18.1, C21.2, C22.2, C23.2, C24.2, C25.2, D6.1 (GND), J1.1, J2.4, J3.9, J3.10, J3.19, J3.20, J5.A1 (GND), J5.A12 (GND), J5.B1 (GND), J5.B12 (GND), J5.S1 (SHIELD), J6.5, J7.2, J7.10, J7.12, J7.13, J7.14, J7.15, J7.16, J7.17, J7.18, J7.19, J7.20, J7.21, J7.22, J7.23, J7.24, J7.25, J7.26, J7.27, J7.28, J7.40, Q2.2 (S), R2.1, R4.1, R5.2, R7.1, R8.1, R9.1, R10.2, R13.2, R14.2, R30.2, R31.2, R32.2, R33.2, R34.2, R35.2, SW1.2, TP16.1 (1_1), TP17.1 (1_1), U1.8 (VSS), U1.14 (TMR), U1.17 (VSS), U2.1 (CTG), U2.4 (GND), U2.6 (QSTRT), U2.9 (EP), U3.3 (AGND), U3.5 (PGND), U4.1 (GND), U4.40 (GND), U4.41 (GND), U5.4 (VSS), U6.5 (GND)
IO_EXT1: TP22.1 (1_1), U4.25 (GPIO48)
IO_MOD1: J3.11, U4.39 (GPIO1/TOUCH1/ADC1_CH0)
IO_MOD2: J3.12, U4.38 (GPIO2/TOUCH2/ADC1_CH1)
IO_MOD3: J3.13, U4.15 (GPIO3/TOUCH3/ADC1_CH2)
IO_MOD4: J3.14, U4.4 (GPIO4/TOUCH4/ADC1_CH3)
IO_MOD5: J3.15, U4.5 (GPIO5/TOUCH5/ADC1_CH4)
IO_MOD6: J3.16, U4.6 (GPIO6/TOUCH6/ADC1_CH5)
IO_MOD7: J3.17, U4.7 (GPIO7/TOUCH7/ADC1_CH6)
IO_MOD8: J3.18, U4.12 (GPIO8/TOUCH8/ADC1_CH7)
LCD_BL: R34.1, TP28.1 (1_1), U4.31 (GPIO38), U6.6 (EN/PWM)
LCD_CS: J7.31, TP25.1 (1_1), U4.18 (GPIO10/TOUCH10/ADC1_CH9)
LCD_DC: J7.29, TP23.1 (1_1), U4.24 (GPIO47)
LCD_MOSI: J7.32, TP26.1 (1_1), U4.19 (GPIO11/TOUCH11/ADC2_CH0)
LCD_RST: J7.11, R33.1, TP27.1 (1_1), U4.32 (MTCK/GPIO39/CLK_OUT3/SUBSPICS1)
LCD_SCK: J7.30, TP24.1 (1_1), U4.20 (GPIO12/TOUCH12/ADC2_CH1)
unnamed: D1.1 (K), D2.1 (K), SW1.1
unnamed: C17.1, D3.1 (K), D4.1 (K), U5.8 (VDD)
unnamed: F2.1, J5.A4 (VBUS), J5.A9 (VBUS), J5.B4 (VBUS), J5.B9 (VBUS)
unnamed: J1.2, U1.1 (TS)
unnamed: F1.2, J1.3
unnamed: J5.A5 (CC1), R31.1
unnamed: J5.B5 (CC2), R30.1
unnamed: F1.1, Q3.3 (D)
unnamed: C5.2, Q3.1 (G), R10.1
unnamed: R6.2, U1.6 (EN1)
unnamed: R7.2, U1.5 (EN2)
unnamed: R8.2, U1.12 (ILIM)
unnamed: R9.2, U1.16 (ISET)
unnamed: R2.2, U1.15 (ITERM)
unnamed: R4.2, TP3.1 (1_1), U1.4 (~CE)
unnamed: C7.2, R12.2, R14.1, U3.2 (FB)
unnamed: L1.1, U3.6 (SW)
unnamed: R21.2, U4.13 (GPIO19/USB_D-)
unnamed: R22.2, U4.14 (GPIO20/USB_D+)
unnamed: TP11.1 (1_1), U5.7 (CLKO)
unnamed: C18.2, U5.1 (OSCI), Y1.2
unnamed: U5.2 (OSCO), Y1.1
unnamed: TP12.1 (1_1), U5.3 (~INT)
unnamed: R35.1, U6.8 (RSET)
PRES_USB: C8.1, R11.2, R13.1, U4.35 (MTMS/GPIO42)
PWR_HOLD: Q2.1 (G), R5.1, U4.23 (GPIO21)
PWR_KEY: D1.2 (A), R1.2, U4.17 (GPIO9/TOUCH9/ADC1_CH8)
USB_D+: C15.2, D6.2 (I/O1), J5.A6 (D+), J5.B6 (D+), R22.1
USB_D-: C16.2, D6.3 (I/O2), J5.A7 (D-), J5.B7 (D-), R21.1
